Nurazkhan/NiRadio/README.md

# NiRadio 
Communication board with RPI2040 and SX1262 on base. Use low power to access long range.

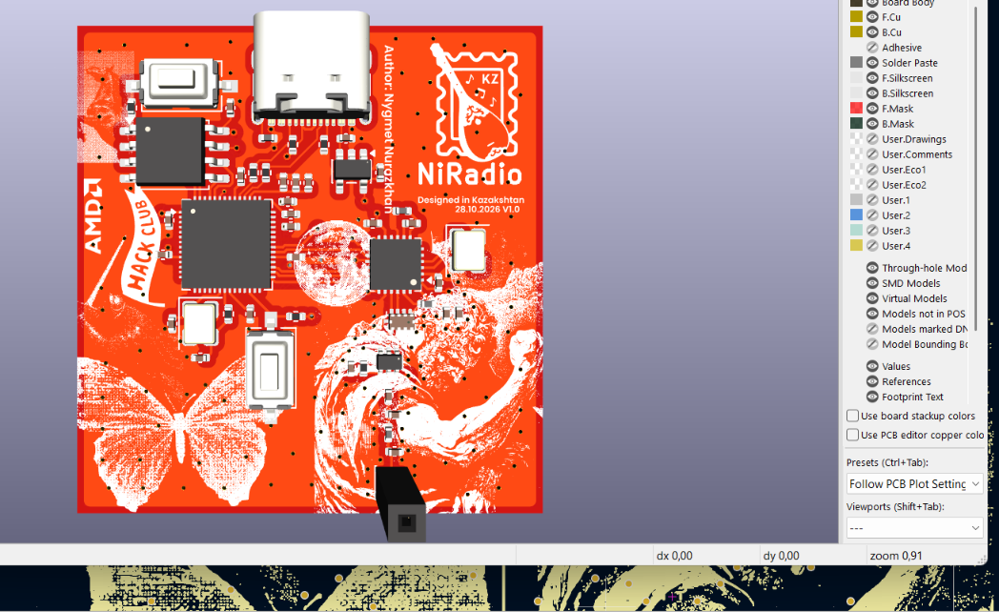
[picture p1: images/image.png]


---
The NiRadio board consists of several parts and layers.

there are 4 copper layers.
1. GND filled layer
2. 3V3 filled layer
3. GND filled Layer
4. GNF filled layer

The core components of the board are SX1262 Radio Transceiver module and RPI2040 MicroController unit.
Starting from SX1262 module. It required connection with crystall oscillator and 32MHz crystal was used and connected on pins SX_XTB and SX_XTA.
Apart from that SX1262 frontend is done with low frequency pass filter for that reason PE4259 with combination 0900FM15K0039 parts were placed.
Then there is an antenna.
Next RPI2040 is connected to QSPI flash memory W25Q128JVS 128Mbit Apart from that it uses 12 MHz crystall oscillator. More about rpi2040 you can see in my [NiroRPI-devboard repo](https://github.com/Nurazkhan/NiroRPI-devboard/tree/main)
The connection between SX1262 radio transceiver and RPI2040 is based on SPI protocol.

Another Important Aspect is powering. To get required 3V3 from 5V the AP2112K-3.3 stable regulator that allows to pass current under 600mA, which is more than enough for this board.
The power delievered either directly through the board front copper layer 1, or through layer2 3v3.

To reduce the noise ferrite bead BLM15AX102SN1D was used. Power and data delivered through USB Type C receptable.
Apart from than, Via fence and stitching can be seen all over the board. As it reduces the noise near the components, and provides stability.

---
## BOM

| Name | Value | Quantity | Price | Min Buy Price | Link |
|---|---|---:|---:|---:|---|
| 0402 Capacitor | 1uF | 2pc | $0.04/pc | $2.00 | [AliExpress](https://www.aliexpress.com/item/1005007464553853.html) |
| 0402 Capacitor | 1nF | 1pc | $0.06/pc  | $2.88 | [AliExpress](https://www.aliexpress.com/item/1005007116834627.html) |
| 0402 Capacitor | 100nF | 12pc | $0.01/pc* | $1.24* | [AliExpress](https://www.aliexpress.com/item/1005007464553853.html) |
| RF Switch | PE4259, SC-70-6 | 1pc | $0.23/pc | $0.23 | [AliExpress search](https://www.aliexpress.com/wholesale?SearchText=PE4259+SC70-6) |
| 0402 Capacitor | 10uF | 2pc | |$2.00 | [AliExpress search](https://www.aliexpress.com/wholesale?SearchText=0402+10uF+capacitor) |
| 0402 Inductor | 47nH | 1pc | | $2.00| [AliExpress search](https://www.aliexpress.com/wholesale?SearchText=0402+47nH+inductor) |
| 0402 Resistor | 10K | 1pc | $0.0096/pc* | $0.96* | [AliExpress](https://www.aliexpress.com/item/1005008478030316.html) |
| Tactile Switch | CK PTS636Sx25SMTRLFS | 2pc | |$2.00 | [AliExpress search](https://www.aliexpress.com/wholesale?SearchText=PTS636Sx25SMTRLFS) |
| Microcontroller QFN-56 | RP2040 | 1pc | $2.32 | $4.64 | [AliExpress](https://www.aliexpress.com/item/1005006481247856.html) |
| Crystal SMD 3225 | 12MHz | 1pc | $0.30* | $2.75* | [AliExpress](https://www.aliexpress.com/item/1005007282073350.html) |
| 0402 Capacitor | 3.3pF | 2pc | |$2.00 | [AliExpress search](https://www.aliexpress.com/wholesale?SearchText=0402+3.3pF+capacitor) |
| 0402 Capacitor | 47nF | 2pc | | $2.00| [AliExpress search](https://www.aliexpress.com/wholesale?SearchText=0402+47nF+capacitor) |
| 0402 Resistor | 1K | 2pc | $0.0096/pc* | $0.96* | [AliExpress](https://www.aliexpress.com/item/1005008478030316.html) |
| Pin Socket | 1x01, 2.54mm Vertical | 1pc | | $1.24| [AliExpress search](https://www.aliexpress.com/wholesale?SearchText=1+pin+female+header+2.54mm) |
| 0402 Capacitor | 39pF | 1pc | | $1.24| [AliExpress search](https://www.aliexpress.com/wholesale?SearchText=0402+39pF+capacitor) |
| NOR Flash Memory | W25Q128JVS | 1pc | $0.61 | $0.61 | [AliExpress](https://www.aliexpress.com/item/1005009949894136.html) |
| 0402 Inductor | 9.1nH | 1pc | | $1.24| [AliExpress search](https://www.aliexpress.com/wholesale?SearchText=0402+9.1nH+inductor) |
| 0402 Resistor | 27.4Ω | 2pc | | $1.24| [AliExpress search](https://www.aliexpress.com/wholesale?SearchText=0402+27.4+ohm+resistor) |
| Ferrite Bead | BLM15AX102SN1D | 1pc | |$1.24 | [AliExpress search](https://www.aliexpress.com/wholesale?SearchText=BLM15AX102SN1D) |
| RF Transceiver QFN-24 | SX1262IMLTRT | 1pc | |$1.24 | [AliExpress search](https://www.aliexpress.com/wholesale?SearchText=SX1262IMLTRT) |
| 0402 Capacitor | 15pF | 2pc | | $1.24| [AliExpress search](https://www.aliexpress.com/wholesale?SearchText=0402+15pF+capacitor) |
| Crystal SMD 3225 | 32MHz | 1pc | | $3| [AliExpress search](https://www.aliexpress.com/wholesale?SearchText=32MHz+3225+SMD+crystal) |
| USB-C Receptacle | GCT USB4105, 16-pin | 1pc | | $2.42| [AliExpress search](https://www.aliexpress.com/wholesale?SearchText=GCT+USB4105) |
| 0402 Inductor | 12uH | 1pc | |$1.88 | [AliExpress search](https://www.aliexpress.com/wholesale?SearchText=0402+12uH+inductor) |
| RF Matching Filter | Johanson 0900FM15K0039 | 1pc | |$3.24 | [AliExpress search](https://www.aliexpress.com/wholesale?SearchText=0900FM15K0039) |
| 0402 Resistor | 5.1K | 2pc | $0.0096/pc* | $0.96* | [AliExpress](https://www.aliexpress.com/item/1005008478030316.html) |
| 0402 Resistor | 100Ω | 1pc | | $1.24| [AliExpress search](https://www.aliexpress.com/wholesale?SearchText=0402+100+ohm+resistor) |
| 0402 Capacitor | 470nF | 1pc | |$1.24 | [AliExpress search](https://www.aliexpress.com/wholesale?SearchText=0402+470nF+capacitor) |
| LDO Voltage Regulator | AP2112K-3.3, SOT-23-5 | 1pc | |$2.35 | [AliExpress search](https://www.aliexpress.com/wholesale?SearchText=AP2112K-3.3) |

*total: ~$51.3 (if bought seperate) and ~30 if to buy components in kit* 

*Price doesnt include layer devboard production*

---
## Scheme
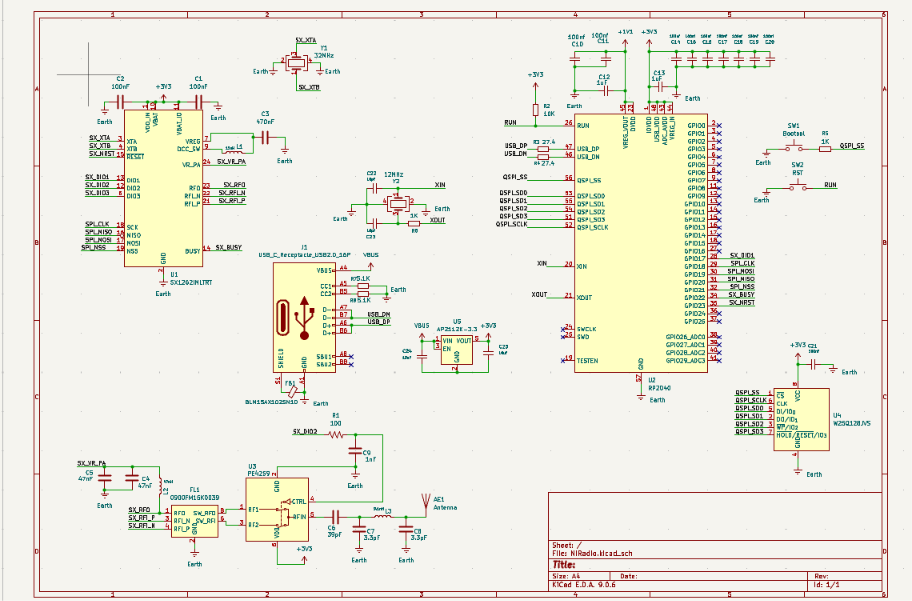
[picture p2: images/Screenshot 2026-10-26 150858.png]

* Pins and connections done using local  labels. 
* Scheme logically divided into 4 parts
1. SX1262 including its crystall oscillator, and pins
2. Frontend for SX1262 including antenna, Frequency filters etc
3. RPI2040 MCU including Flash Memory, crystall Oscillator, decoupling capacitors and buttons for run and reset.
4. Power including TYPE C receptable and 3V3 Regulator

---
## PCB layout

#### Front copper Layer and Back Copper Layer

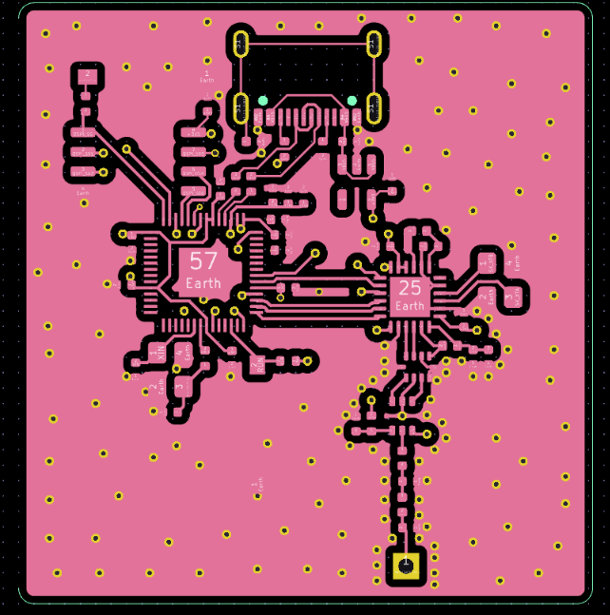
[picture p3: images/image-4.png]

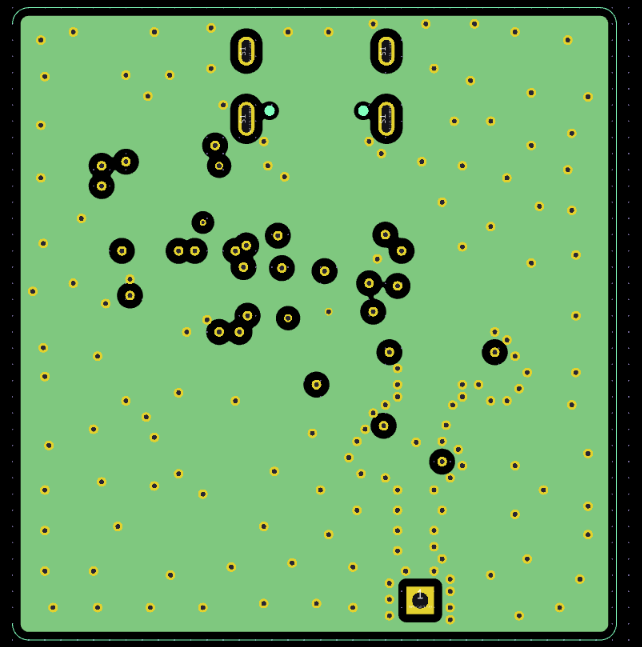
[picture p4: images/image-1.png]

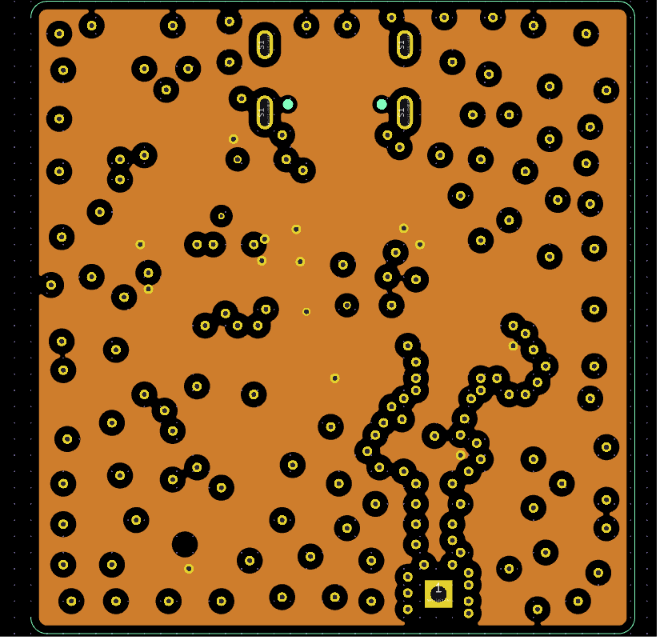
[picture p5: images/image-2.png]

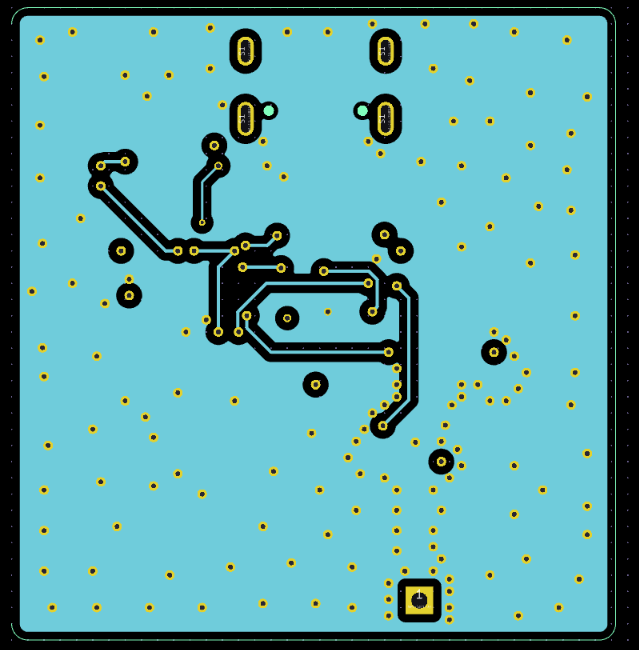
[picture p6: images/image-3.png]

( SilkScreen hidden )

## front and back with silkscreen
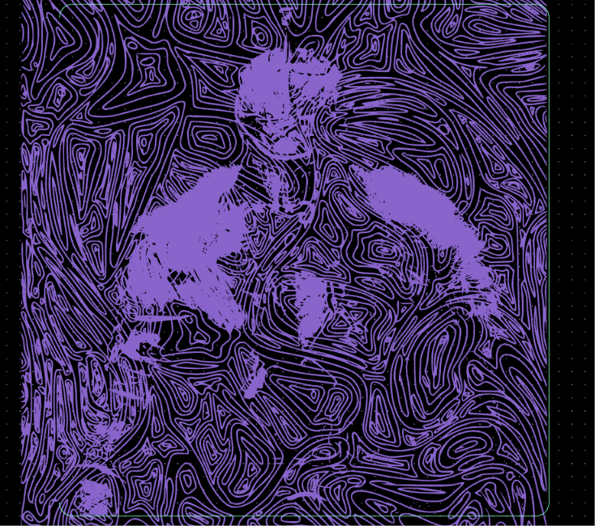
[picture p7: images/image-5.png]
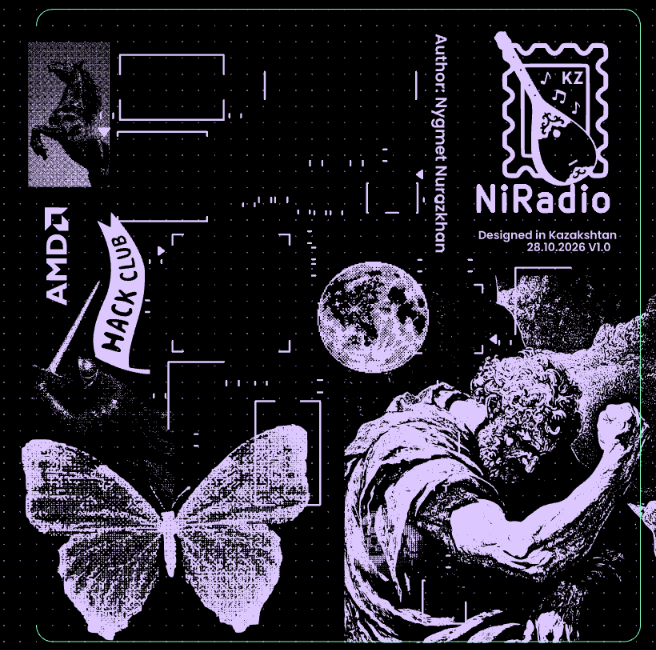
[picture p8: images/image-6.png]
 

## 3D view front and back


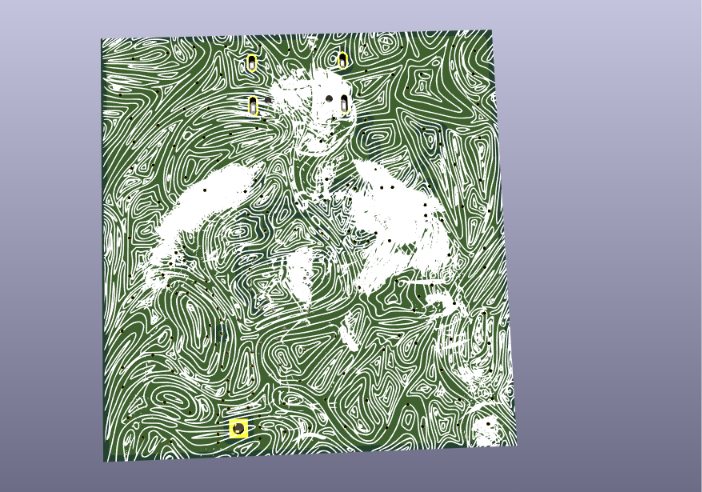
[picture p9: images/Screenshot 2026-10-28 152332.png]


# Thank you, hack club!
