Nurazkhan/NiRadio/art/3eaea21e610c89dae154695eb36d4d1b.jpg

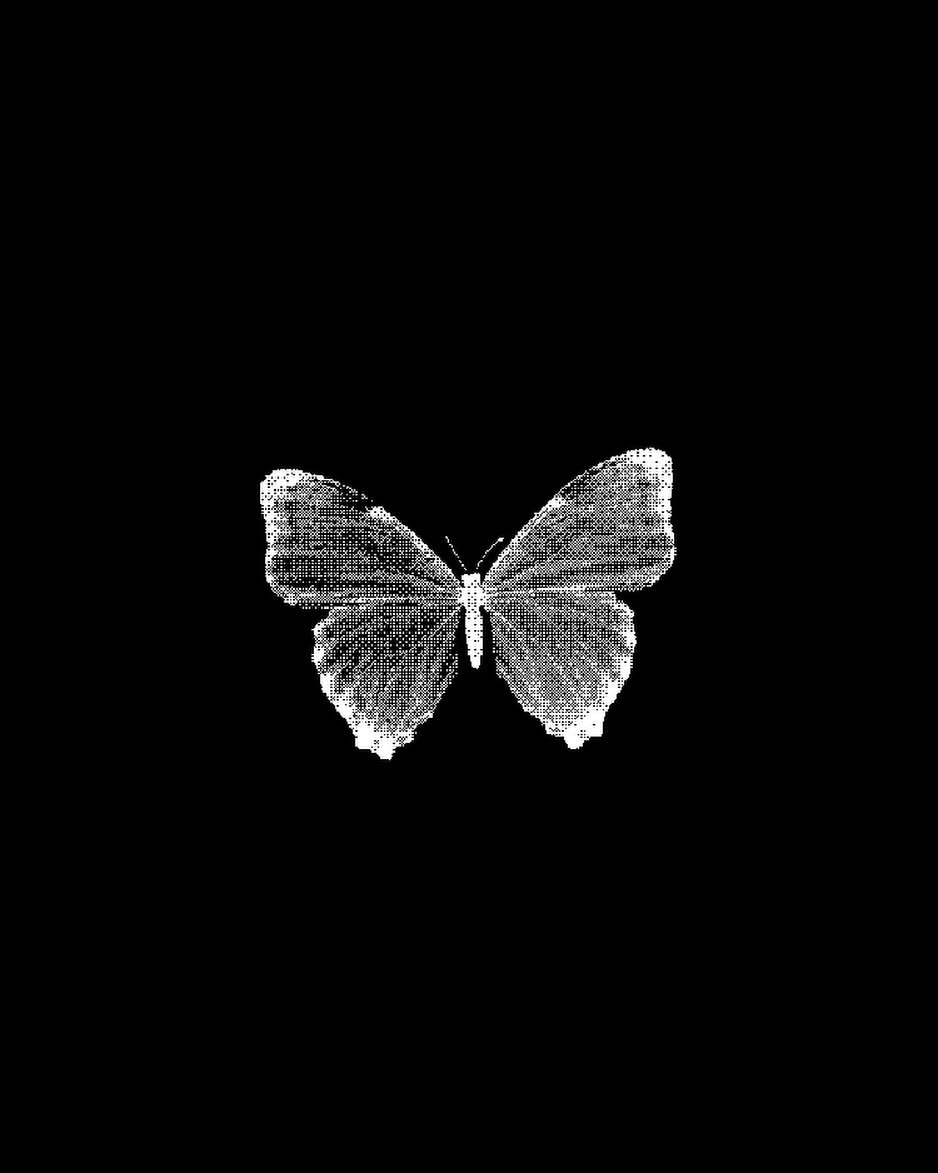
art/3eaea21e610c89dae154695eb36d4d1b.jpg
