Nurazkhan/NiRadio/art/91aff6d85e257697db45f61f82fdd373.jpg

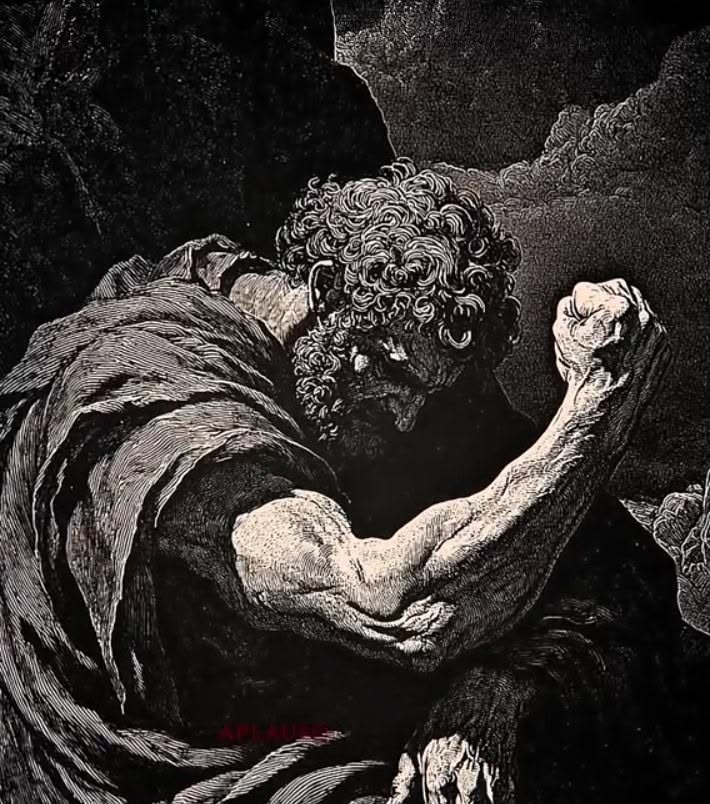
art/91aff6d85e257697db45f61f82fdd373.jpg
