Nurazkhan/NiRadio/art/3067f49c9dde27b04561bffb91b68e9e.jpg

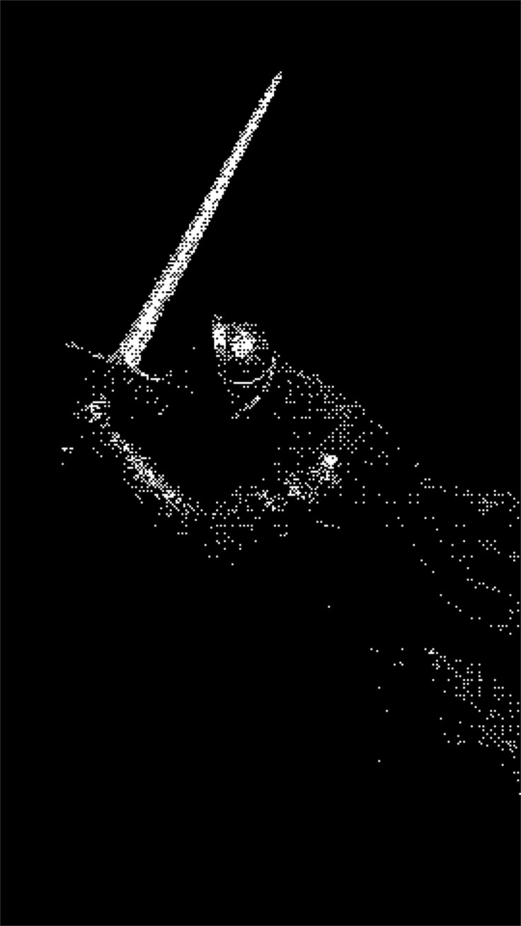
art/3067f49c9dde27b04561bffb91b68e9e.jpg
