Nurazkhan/NiRadio/art/de9bba4283ad8ce28b63d6064f36b04c.jpg

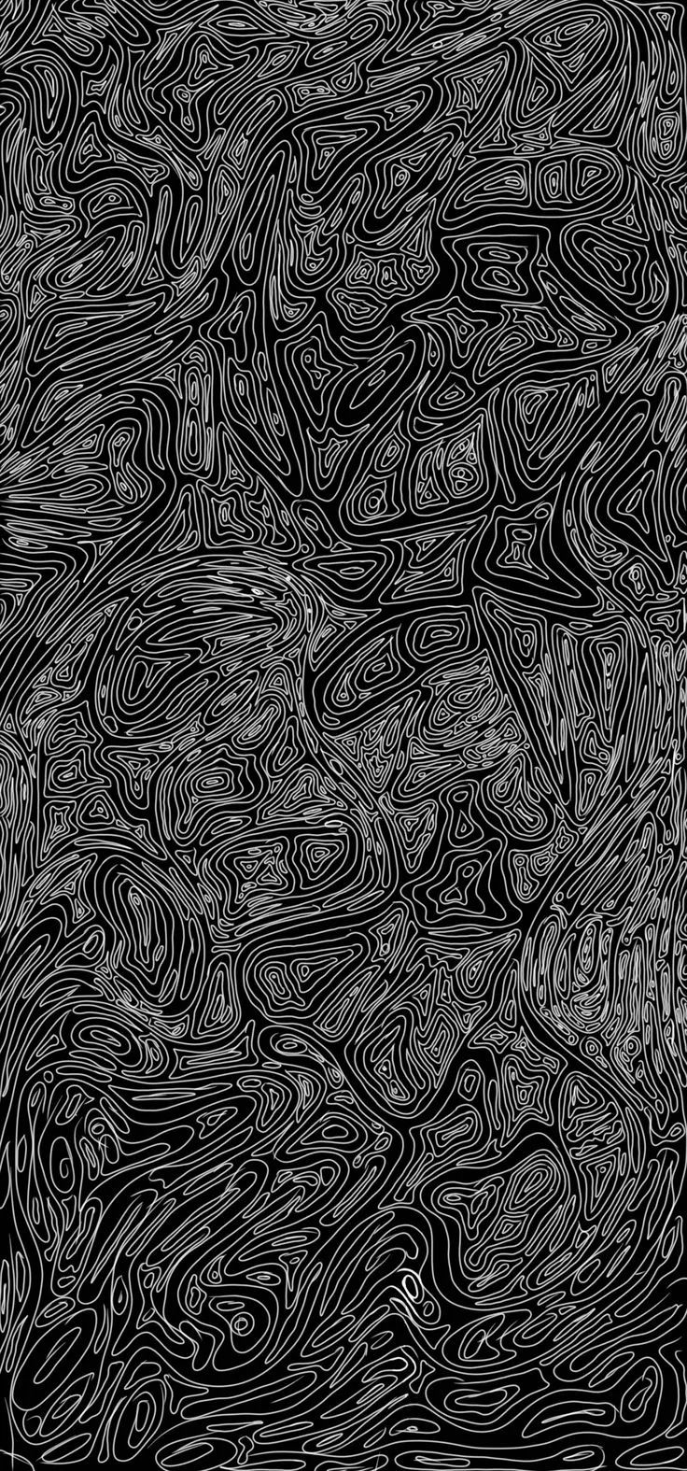
art/de9bba4283ad8ce28b63d6064f36b04c.jpg
