Nurazkhan/NiRadio/art/e106e127ab9c45857fbec1686262c94e.jpg

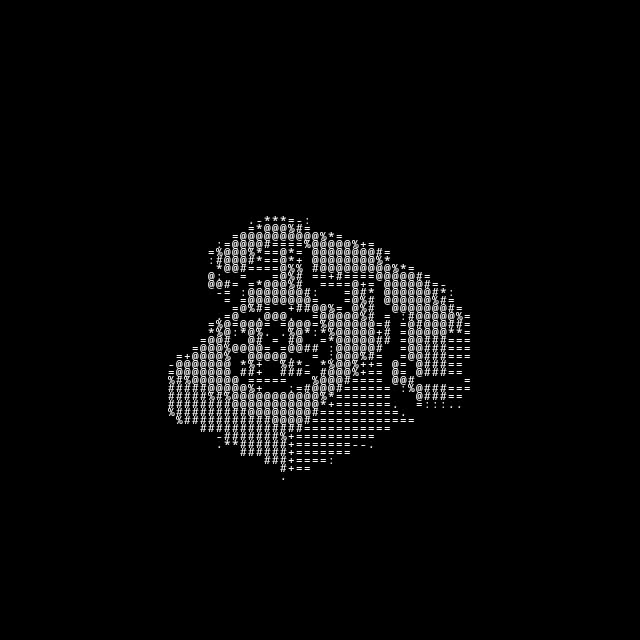
art/e106e127ab9c45857fbec1686262c94e.jpg
