Nurazkhan/NiRadio/art/eac965ac9f336c7898047fb10723e252.jpg

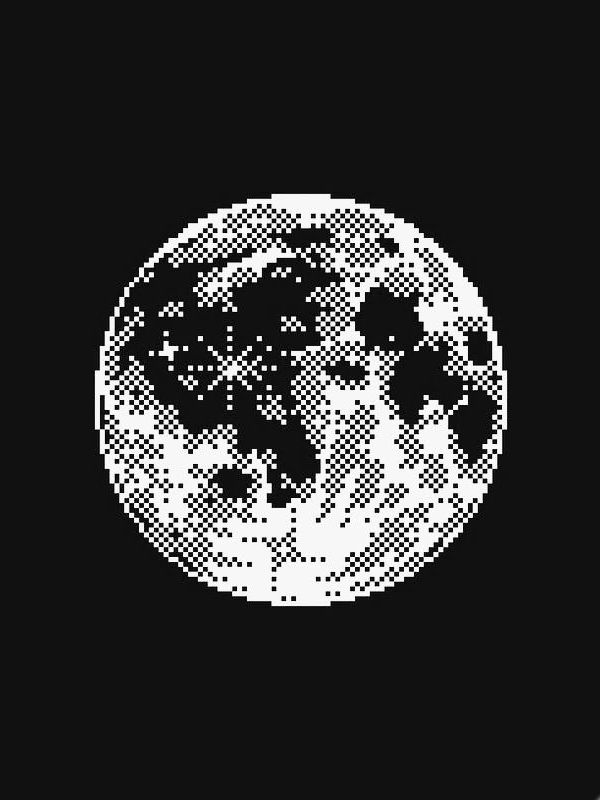
art/eac965ac9f336c7898047fb10723e252.jpg
