Nurazkhan/NiRadio/art/fbbbab83fb542b7b65b0c98ff01bcd54.jpg

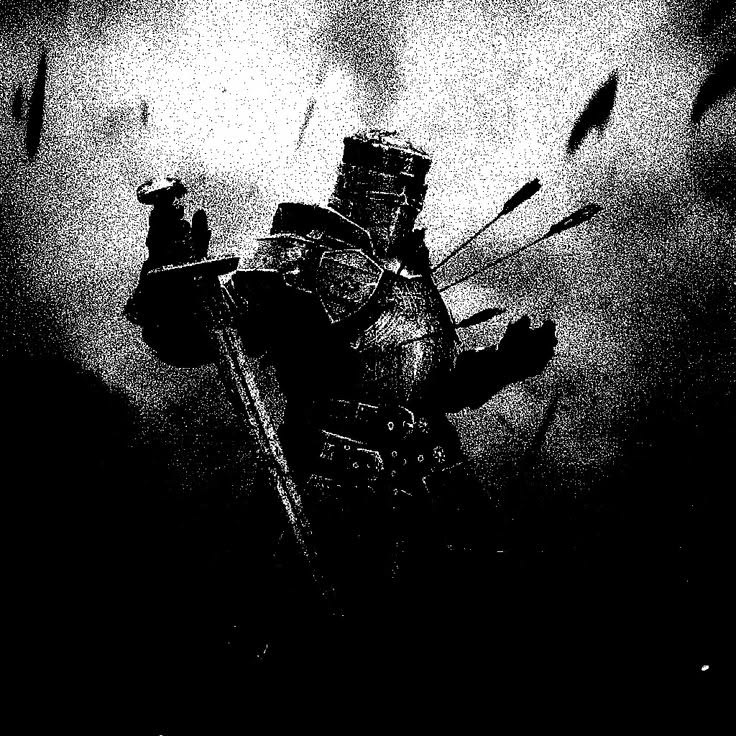
art/fbbbab83fb542b7b65b0c98ff01bcd54.jpg
