Nurazkhan/NiRadio/art/images.png

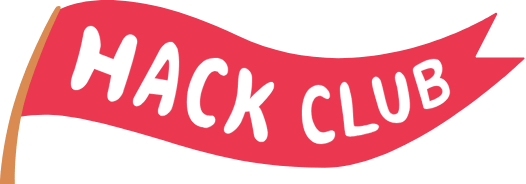
art/images.png
