Nurazkhan/NiRadio/art/photo_2026-10-28_14-38-23.jpg

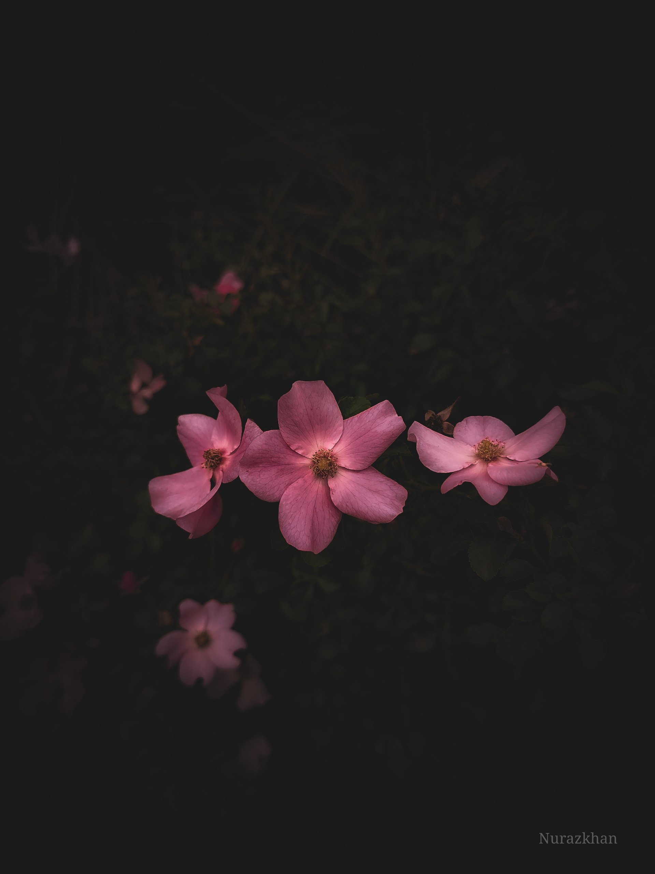
art/photo_2026-10-28_14-38-23.jpg
