Nurazkhan/NiRadio/BOM.CSV

Reference | Component | Value | Package | Quantity | Unit Price USD | Minimum Purchase Cost USD | AliExpress Link
C13;C12 | Capacitor | 1uF | 0402 | 2 | 0.04 | 2.00 | https://www.aliexpress.com/item/1005007464553853.html
C9 | Capacitor | 1nF | 0402 | 1 | 0.06 | 2.88 | https://www.aliexpress.com/item/1005007116834627.html
C15;C14;C10;C19;C18;C20;C17;C21;C11;C16 | Capacitor | 100nF | 0402 | 10 | 0.01 | 1.24 | https://www.aliexpress.com/item/1005007464553853.html
U3 | RF Switch | PE4259 | SOT-363 SC-70-6 | 1 | 0.23 | 0.23 | https://www.aliexpress.com/wholesale?SearchText=PE4259+SC70-6
C25;C24 | Capacitor | 10uF | 0402 | 2 |  | 2.00 | https://www.aliexpress.com/wholesale?SearchText=0402+10uF+capacitor
L2 | Inductor | 47nH | 0402 | 1 |  | 2.00 | https://www.aliexpress.com/wholesale?SearchText=0402+47nH+inductor
R2 | Resistor | 10K | 0402 | 1 | 0.0096 | 0.96 | https://www.aliexpress.com/item/1005008478030316.html
SW1 | Tactile Switch | CK PTS636Sx25SMTRLFS | SMD | 1 |  | 2.00 | https://www.aliexpress.com/wholesale?SearchText=PTS636Sx25SMTRLFS
U2 | Microcontroller | RP2040 | QFN-56 | 1 | 2.32 | 4.64 | https://www.aliexpress.com/item/1005006481247856.html
Y2 | Crystal | 12MHz | 3225 SMD | 1 | 0.30 | 2.75 | https://www.aliexpress.com/item/1005007282073350.html
C7;C8 | Capacitor | 3.3pF | 0402 | 2 |  | 2.00 | https://www.aliexpress.com/wholesale?SearchText=0402+3.3pF+capacitor
C5;C4 | Capacitor | 47nF | 0402 | 2 |  | 2.00 | https://www.aliexpress.com/wholesale?SearchText=0402+47nF+capacitor
R5;R6 | Resistor | 1K | 0402 | 2 | 0.0096 | 0.96 | https://www.aliexpress.com/item/1005008478030316.html
C2;C1 | Capacitor | 100nF | 0402 | 2 | 0.01 | 1.24 | https://www.aliexpress.com/item/1005007464553853.html
SW2 | Tactile Switch | CK PTS636Sx25SMTRLFS | SMD | 1 |  | 2.00 | https://www.aliexpress.com/wholesale?SearchText=PTS636Sx25SMTRLFS
AE1 | Pin Socket | 1x01 2.54mm Vertical | Through-hole | 1 |  | 1.24 | https://www.aliexpress.com/wholesale?SearchText=1+pin+female+header+2.54mm
C6 | Capacitor | 39pF | 0402 | 1 |  | 1.24 | https://www.aliexpress.com/wholesale?SearchText=0402+39pF+capacitor
U4 | NOR Flash Memory | W25Q128JVS | SOIC-8 | 1 | 0.61 | 0.61 | https://www.aliexpress.com/item/1005009949894136.html
L3 | Inductor | 9.1nH | 0402 | 1 |  | 1.24 | https://www.aliexpress.com/wholesale?SearchText=0402+9.1nH+inductor
R4;R3 | Resistor | 27.4Ohm | 0402 | 2 |  | 1.24 | https://www.aliexpress.com/wholesale?SearchText=0402+27.4+ohm+resistor
FB1 | Ferrite Bead | BLM15AX102SN1D | 0402 | 1 |  | 1.24 | https://www.aliexpress.com/wholesale?SearchText=BLM15AX102SN1D
U1 | RF Transceiver | SX1262IMLTRT | QFN-24 | 1 |  | 1.24 | https://www.aliexpress.com/wholesale?SearchText=SX1262IMLTRT
C22;C23 | Capacitor | 15pF | 0402 | 2 |  | 1.24 | https://www.aliexpress.com/wholesale?SearchText=0402+15pF+capacitor
Y1 | Crystal | 32MHz | 3225 SMD | 1 |  | 3.00 | https://www.aliexpress.com/wholesale?SearchText=32MHz+3225+SMD+crystal
J1 | USB-C Receptacle | GCT USB4105 16-pin | SMD | 1 |  | 2.42 | https://www.aliexpress.com/wholesale?SearchText=GCT+USB4105
L1 | Inductor | 12uH | 0402 | 1 |  | 1.88 | https://www.aliexpress.com/wholesale?SearchText=0402+12uH+inductor
FL1 | RF Matching Filter | Johanson 0900FM15K0039 | SMD | 1 |  | 3.24 | https://www.aliexpress.com/wholesale?SearchText=0900FM15K0039
R8;R7 | Resistor | 5.1K | 0402 | 2 | 0.0096 | 0.96 | https://www.aliexpress.com/item/1005008478030316.html
R1 | Resistor | 100Ohm | 0402 | 1 |  | 1.24 | https://www.aliexpress.com/wholesale?SearchText=0402+100+ohm+resistor
C3 | Capacitor | 470nF | 0402 | 1 |  | 1.24 | https://www.aliexpress.com/wholesale?SearchText=0402+470nF+capacitor
U5 | LDO Voltage Regulator | AP2112K-3.3 | SOT-23-5 | 1 |  | 2.35 | https://www.aliexpress.com/wholesale?SearchText=AP2112K-3.3
