Nurazkhan/NiRadio/pcb/NiRadioAutoBOM.csv

Id | Designator | Footprint | Quantity | Designation | Supplier and ref
1 | C13,C12 | C_0402_1005Metric | 2 | 1uF
2 | C9 | C_0402_1005Metric | 1 | 1nF
3 | C15,C14,C10,C19,C18,C20,C17,C21,C11,C16 | C_0402_1005Metric | 10 | 100nf
4 | U3 | SOT-363_SC-70-6 | 1 | PE4259
5 | C25,C24 | C_0402_1005Metric | 2 | 10uF
6 | L2 | L_0402_1005Metric | 1 | 47nH
7 | R2 | R_0402_1005Metric | 1 | 10K
8 | SW1 | SW_Tactile_SPST_NO_Straight_CK_PTS636Sx25SMTRLFS | 1 | Bootsel
9 | U2 | QFN-56-1EP_7x7mm_P0.4mm_EP3.2x3.2mm | 1 | RP2040
10 | Y2 | Crystal_SMD_Abracon_ABM8G-4Pin_3.2x2.5mm | 1 | 12MHz
11 | C7,C8 | C_0402_1005Metric | 2 | 3.3pF
12 | C5,C4 | C_0402_1005Metric | 2 | 47nF
13 | R5,R6 | R_0402_1005Metric | 2 | 1K
14 | C2,C1 | C_0402_1005Metric | 2 | 100nF
15 | SW2 | SW_Tactile_SPST_NO_Straight_CK_PTS636Sx25SMTRLFS | 1 | RST
16 | AE1 | PinSocket_1x01_P2.54mm_Vertical | 1 | Antenna
17 | C6 | C_0402_1005Metric | 1 | 39pF
18 | U4 | SOIC-8_5.3x5.3mm_P1.27mm | 1 | W25Q128JVS
19 | L3 | L_0402_1005Metric | 1 | 9.1nH
20 | R4,R3 | R_0402_1005Metric | 2 | 27.4
21 | FB1 | L_0402_1005Metric | 1 | BLM15AX102SN1D
22 | U1 | QFN-24-1EP_4x4mm_P0.5mm_EP2.6x2.6mm | 1 | SX1262IMLTRT
23 | C22,C23 | C_0402_1005Metric | 2 | 15pF
24 | Y1 | Crystal_SMD_3225-4Pin_3.2x2.5mm | 1 | 32MHz
25 | J1 | USB_C_Receptacle_GCT_USB4105-xx-A_16P_TopMnt_Horizontal | 1 | USB_C_Receptacle_USB2.0_16P
26 | L1 | L_0402_1005Metric | 1 | 12uH
27 | FL1 | Balun_Johanson_0900FM15K0039 | 1 | 0900FM15K0039
28 | R8,R7 | R_0402_1005Metric | 2 | 5.1K
29 | R1 | R_0402_1005Metric | 1 | 100
30 | C3 | C_0402_1005Metric | 1 | 470nF
31 | U5 | SOT-23-5 | 1 | AP2112K-3.3
