Nurazkhan/NiRadio/pcb/NiRadio.kicad_pcb

## KiCad design pcb/NiRadio.kicad_pcb (2026-10-29)

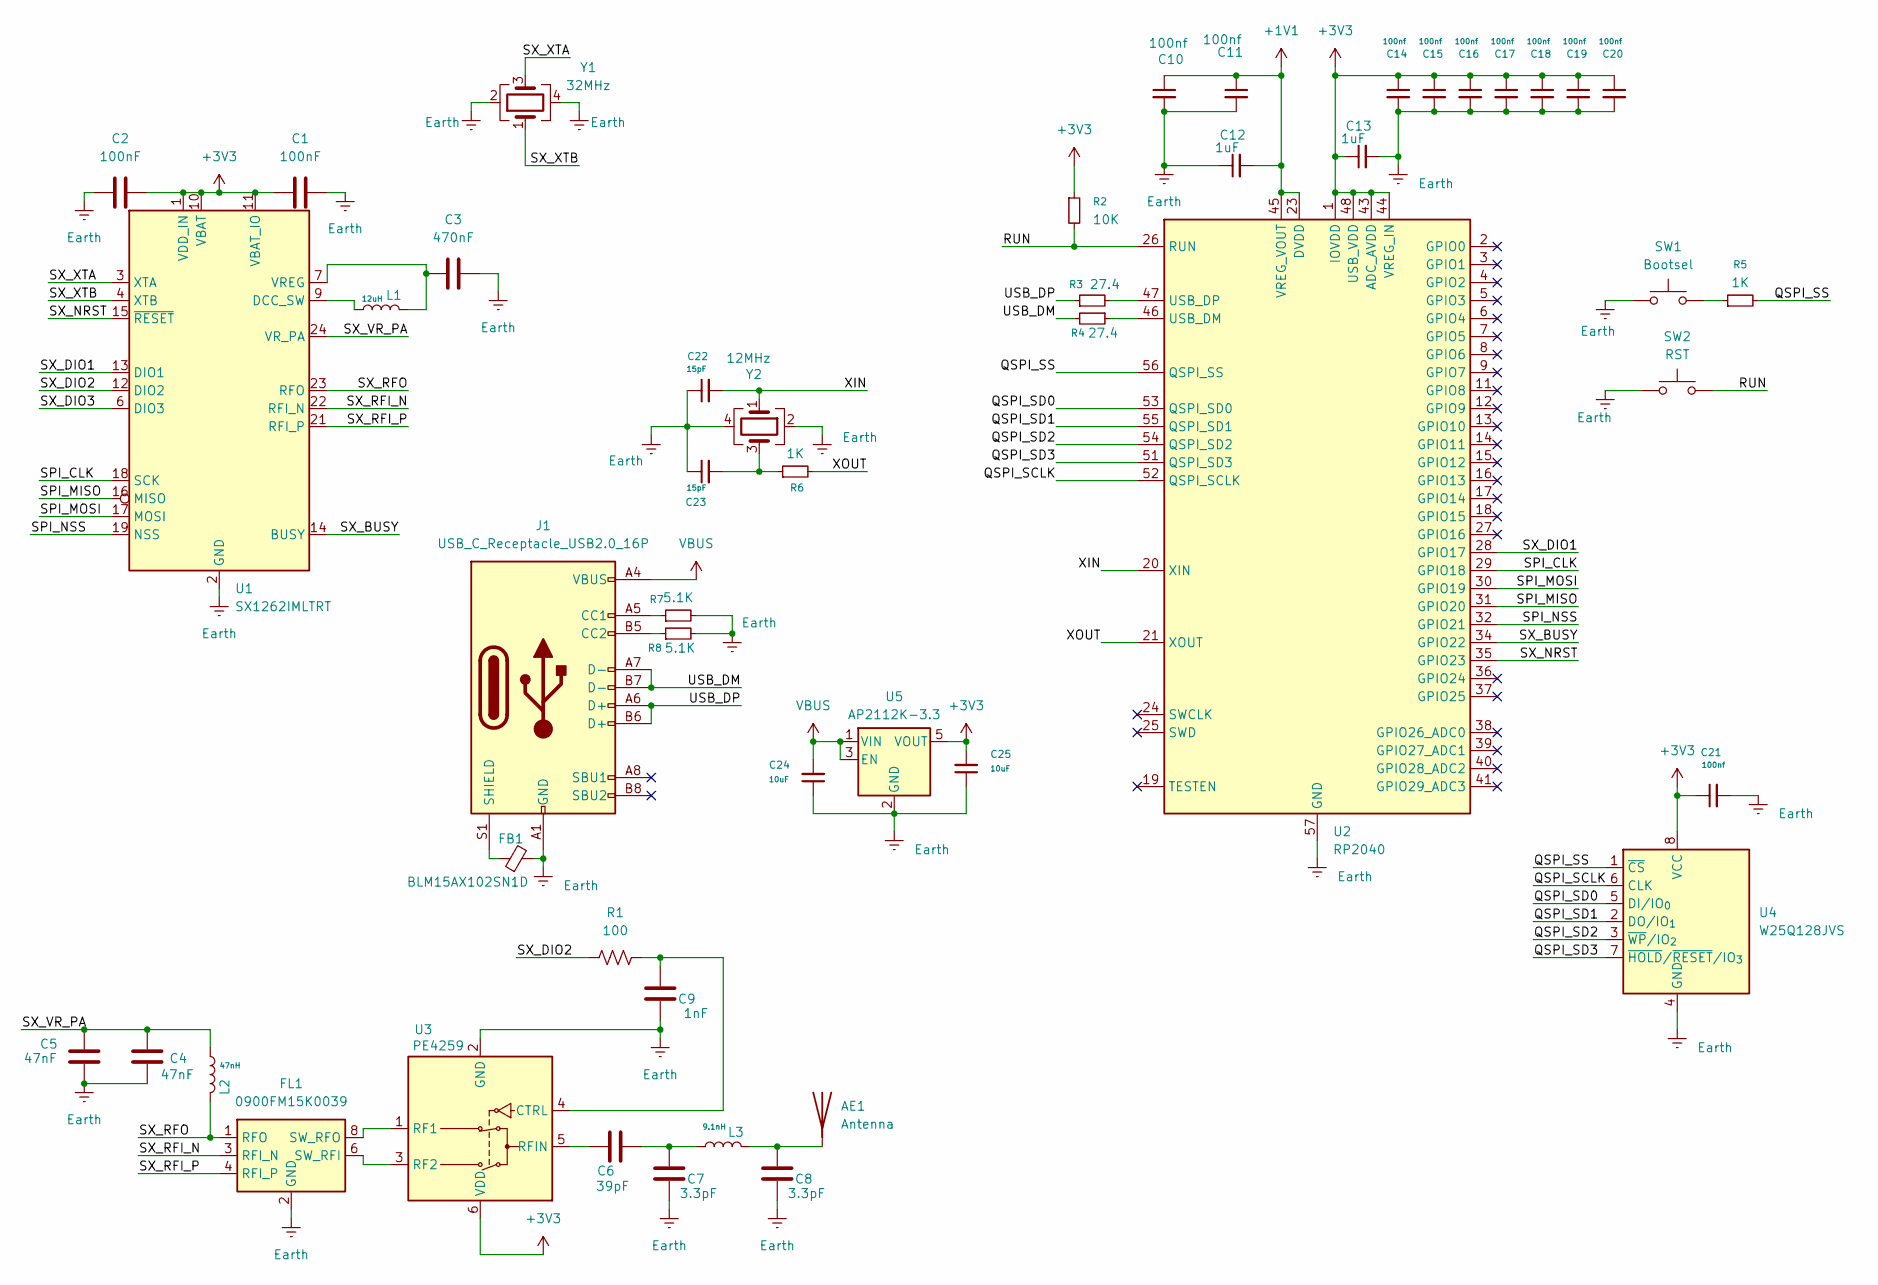
[picture p19: schematic NiRadio.kicad_sch]

Parts:
AE1: Antenna; PinSocket_1x01_P2.54mm_Vertical
C1, C2: 100nF; C_0402_1005Metric
C3: 470nF; C_0402_1005Metric
C4, C5: 47nF; C_0402_1005Metric
C6: 39pF; C_0402_1005Metric
C7, C8: 3.3pF; C_0402_1005Metric
C9: 1nF; C_0402_1005Metric
C10, C11, C14, C15, C16, C17, C18, C19, C20, C21: 100nf; C_0402_1005Metric
C12, C13: 1uF; C_0402_1005Metric
C22, C23: 15pF; C_0402_1005Metric
C24, C25: 10uF; C_0402_1005Metric
FB1: BLM15AX102SN1D; L_0402_1005Metric
FL1: 0900FM15K0039; Balun_Johanson_0900FM15K0039
J1: USB_C_Receptacle_USB2.0_16P; USB_C_Receptacle_GCT_USB4105-xx-A_16P_TopMnt_Horizontal
L1: 12uH; L_0402_1005Metric
L2: 47nH; L_0402_1005Metric
L3: 9.1nH; L_0402_1005Metric
R1: 100; R_0402_1005Metric
R2: 10K; R_0402_1005Metric
R3, R4: 27.4; R_0402_1005Metric
R5, R6: 1K; R_0402_1005Metric
R7, R8: 5.1K; R_0402_1005Metric
SW1: Bootsel; SW_Tactile_SPST_NO_Straight_CK_PTS636Sx25SMTRLFS
SW2: RST; SW_Tactile_SPST_NO_Straight_CK_PTS636Sx25SMTRLFS
U1: SX1262IMLTRT; QFN-24-1EP_4x4mm_P0.5mm_EP2.6x2.6mm
U2: RP2040; QFN-56-1EP_7x7mm_P0.4mm_EP3.2x3.2mm
U3: PE4259; SOT-363_SC-70-6
U4: W25Q128JVS; SOIC-8_5.3x5.3mm_P1.27mm
U5: AP2112K-3.3; SOT-23-5
Y1: 32MHz; Crystal_SMD_3225-4Pin_3.2x2.5mm
Y2: 12MHz; Crystal_SMD_Abracon_ABM8G-4Pin_3.2x2.5mm

Connections:
+1V1: C10.1, C11.1, C12.2, U2.23 (DVDD), U2.45 (VREG_VOUT), U2.50 (DVDD)
+3V3: C1.1, C2.2, C13.1, C14.1, C15.1, C16.1, C17.1, C18.1, C19.1, C20.1, C21.1, C25.2, R2.1, U1.1 (VDD_IN), U1.10 (VBAT), U1.11 (VBAT_IO), U2.1 (IOVDD), U2.10 (IOVDD), U2.22 (IOVDD), U2.33 (IOVDD), U2.42 (IOVDD), U2.43 (ADC_AVDD), U2.44 (VREG_IN), U2.48 (USB_VDD), U2.49 (IOVDD), U3.6 (VDD), U4.8 (VCC), U5.5 (VOUT)
/QSPI_SCLK: U2.52 (QSPI_SCLK), U4.6 (CLK)
/QSPI_SD0: U2.53 (QSPI_SD0), U4.5 (DI/IO_{0})
/QSPI_SD1: U2.55 (QSPI_SD1), U4.2 (DO/IO_{1})
/QSPI_SD2: U2.54 (QSPI_SD2), U4.3 (~WP/IO_{2})
/QSPI_SD3: U2.51 (QSPI_SD3), U4.7 (~HOLD/~RESET/IO_{3})
/QSPI_SS: R5.2, U2.56 (QSPI_SS), U4.1 (~CS)
/RUN: R2.2, SW2.2, U2.26 (RUN)
/SPI_CLK: U1.18 (SCK), U2.29 (GPIO18)
/SPI_MISO: U1.16 (MISO), U2.31 (GPIO20)
/SPI_MOSI: U1.17 (MOSI), U2.30 (GPIO19)
/SPI_NSS: U1.19 (NSS), U2.32 (GPIO21)
/SX_BUSY: U1.14 (BUSY), U2.34 (GPIO22)
/SX_DIO1: U1.13 (DIO1), U2.28 (GPIO17)
/SX_DIO2: R1.2, U1.12 (DIO2)
/SX_DIO3: U1.6 (DIO3)
/SX_NRST: U1.15 (~RESET), U2.35 (GPIO23)
/SX_RFI_N: FL1.3 (RFI_N), U1.22 (RFI_N)
/SX_RFI_P: FL1.4 (RFI_P), U1.21 (RFI_P)
/SX_RFO: FL1.1 (RFO), L2.2, U1.23 (RFO)
/SX_VR_PA: C4.2, C5.2, L2.1, U1.24 (VR_PA)
/SX_XTA: U1.3 (XTA), Y1.3
/SX_XTB: U1.4 (XTB), Y1.1
/USB_DM: J1.A7 (D-), J1.B7 (D-), R4.2
/USB_DP: J1.A6 (D+), J1.B6 (D+), R3.1
/XIN: C22.2, U2.20 (XIN), Y2.1
/XOUT: R6.2, U2.21 (XOUT)
Earth: C1.2, C2.1, C3.2, C4.1, C5.1, C7.1, C8.1, C9.1, C10.2, C11.2, C12.1, C13.2, C14.2, C15.2, C16.2, C17.2, C18.2, C19.2, C20.2, C21.2, C22.1, C23.1, C24.1, C25.1, FB1.2, FL1.2 (GND), FL1.5 (GND), FL1.7 (GND), FL1.9 (GND), FL1.10 (GND), J1.A1 (GND), J1.A12 (GND), J1.B1 (GND), J1.B12 (GND), R7.2, R8.2, SW1.1, SW2.1, U1.2 (GND), U1.5 (GND), U1.8 (GND), U1.20 (GND), U1.25 (GND), U2.57 (GND), U3.2 (GND), U4.4 (GND), U5.2 (GND), Y1.2, Y1.4, Y2.2, Y2.4
unnamed: AE1.1 (A), C8.2, L3.2
unnamed: C6.2, C7.2, L3.1
unnamed: C23.2, R6.1, Y2.3
unnamed: FL1.6 (SW_RFI), U3.3 (RF2)
unnamed: FL1.8 (SW_RFO), U3.1 (RF1)
unnamed: J1.A5 (CC1), R7.1
unnamed: J1.B5 (CC2), R8.1
unnamed: FB1.1, J1.S1 (SHIELD)
unnamed: R5.1, SW1.2
unnamed: L1.1, U1.9 (DCC_SW)
unnamed: C3.1, L1.2, U1.7 (VREG)
unnamed: R4.1, U2.46 (USB_DM)
unnamed: R3.2, U2.47 (USB_DP)
unnamed: C9.2, R1.1, U3.4 (CTRL)
unnamed: C6.1, U3.5 (RFIN)
VBUS: C24.2, J1.A4 (VBUS), J1.A9 (VBUS), J1.B4 (VBUS), J1.B9 (VBUS), U5.1 (VIN), U5.3 (EN)

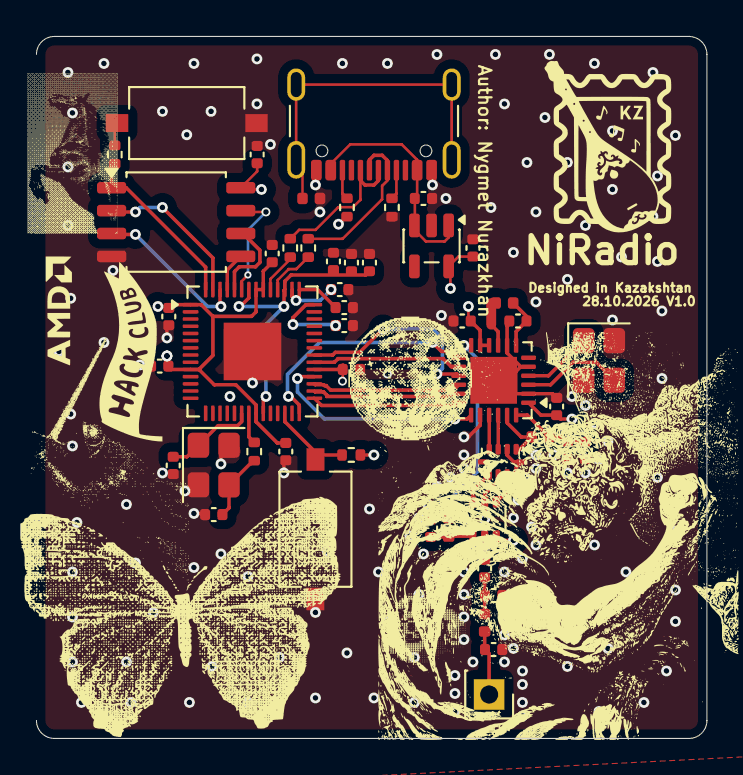
[picture p20: board NiRadio.kicad_pcb from above]

Board: 4 copper layers, 37.2 x 39.0 mm, 49 parts (0 on the bottom side), 44 nets.
