Nurazkhan/NiRadio/(commit log)

2026-10-29 pcb completed
    [NiRadio-B_Cu.gbr, NiRadio-B_Mask.gbr, NiRadio-B_Paste.gbr, NiRadio-B_Silkscreen.gbr, NiRadio-Edge_Cuts.gbr, NiRadio-F_Cu.gbr, NiRadio-F_Mask.gbr, NiRadio-F_Paste.gbr]
2026-10-29 Readme and BOM completed
    [BOM.CSV, NiRadioAutoBOM.csv]
